agoessling/godwit/README.md

godwit
======

Low-Cost Gliding Computer
