agoessling/godwit/hardware/v01/electrical/fab/panelized/README.txt

Board Thickness: 1.6mm
Surface Finish Green Soldermask with White Silkscreen
Copper Weight: 1 Oz. Top and Bottom
