agoessling/godwit/hardware/v01/mechanical/eagleup/eagleUp_godwit-v01_board_bottom.png

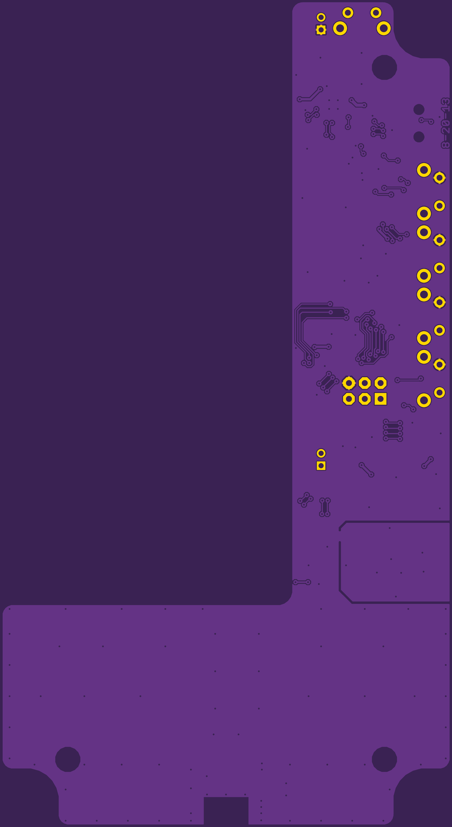
hardware/v01/mechanical/eagleup/eagleUp_godwit-v01_board_bottom.png
