agoessling/godwit/hardware/v01/mechanical/eagleup/eagleUp_godwit-v01_bottom_mask.png

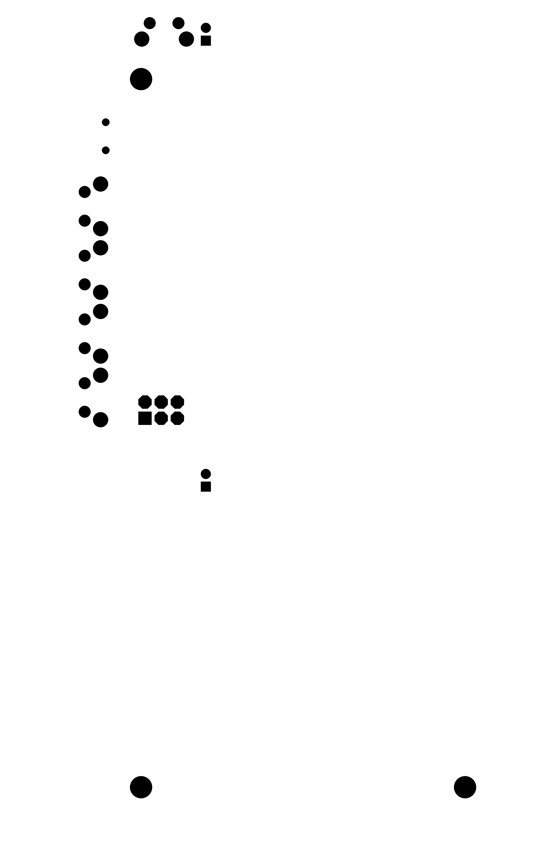
hardware/v01/mechanical/eagleup/eagleUp_godwit-v01_bottom_mask.png
