agoessling/godwit/hardware/v01/mechanical/eagleup/eagleUp_godwit-v01_imagesize.png

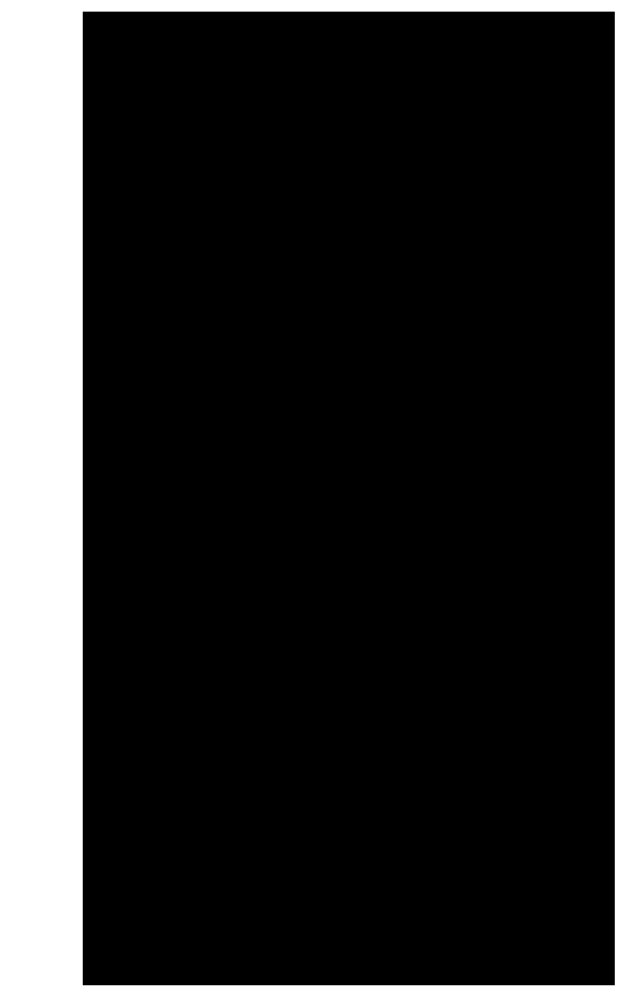
hardware/v01/mechanical/eagleup/eagleUp_godwit-v01_imagesize.png
