agoessling/godwit/hardware/v01/mechanical/eagleup/eagleUp_godwit-v01_outline.png

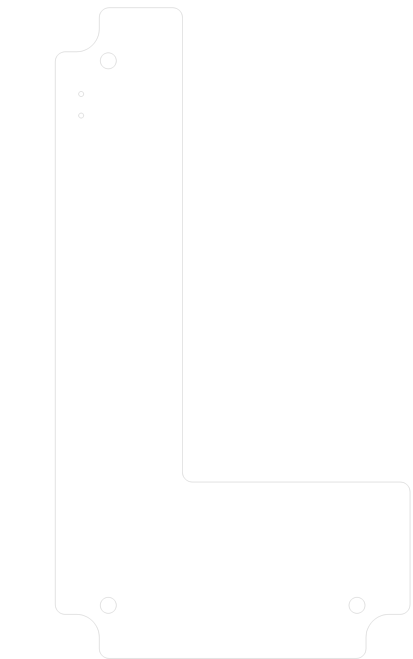
hardware/v01/mechanical/eagleup/eagleUp_godwit-v01_outline.png
