agoessling/godwit/hardware/v01/mechanical/eagleup/eagleUp_godwit-v01_top_mask.png

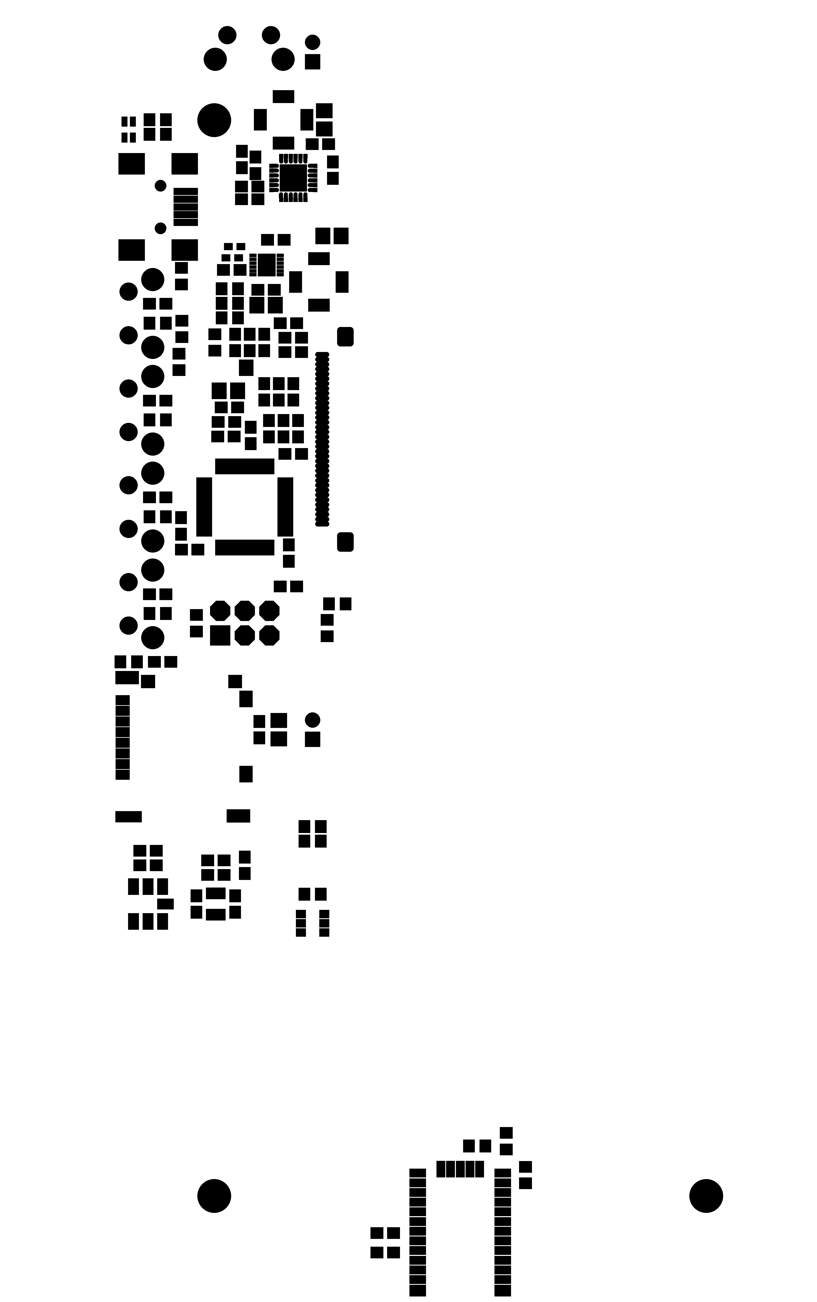
hardware/v01/mechanical/eagleup/eagleUp_godwit-v01_top_mask.png
