agoessling/godwit/hardware/v01/mechanical/eagleup/eagleUp_godwit-v01_top_silk.png

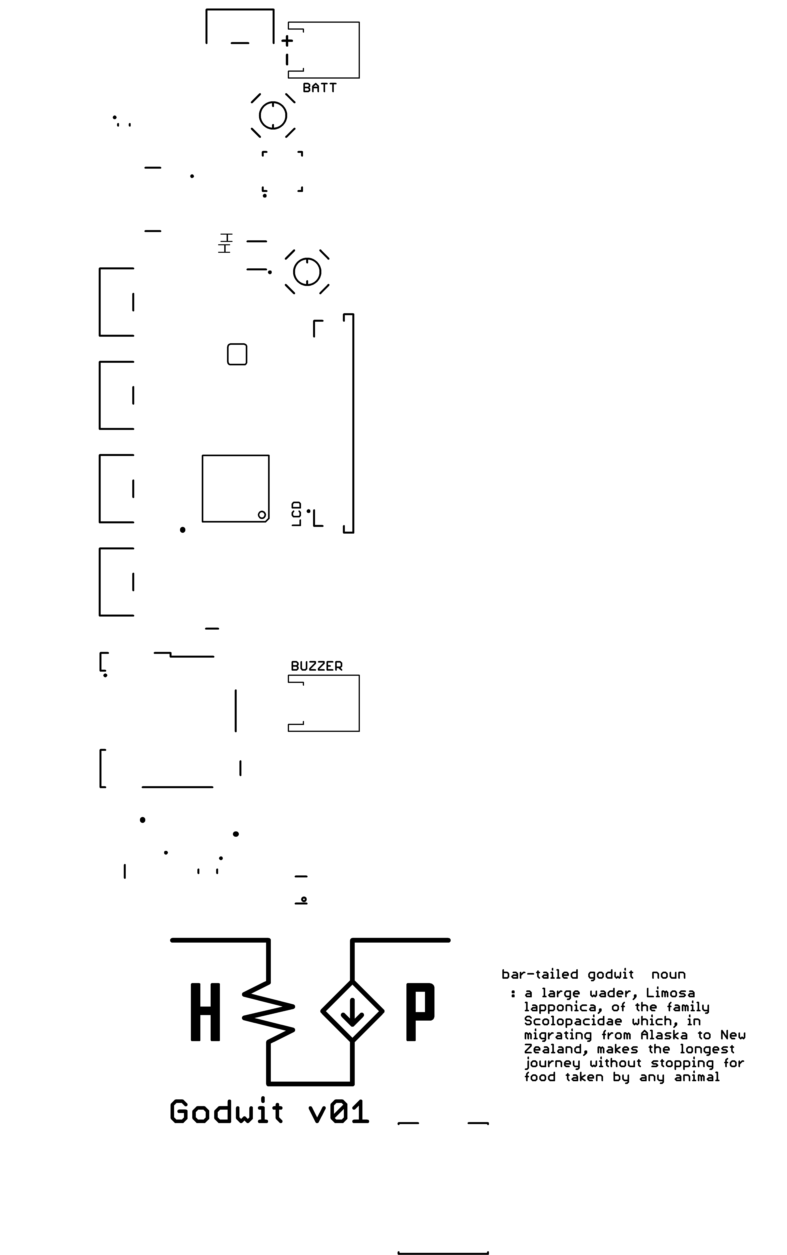
hardware/v01/mechanical/eagleup/eagleUp_godwit-v01_top_silk.png
