agoessling/godwit/hardware/v01/mechanical/godwit_outline.dxf

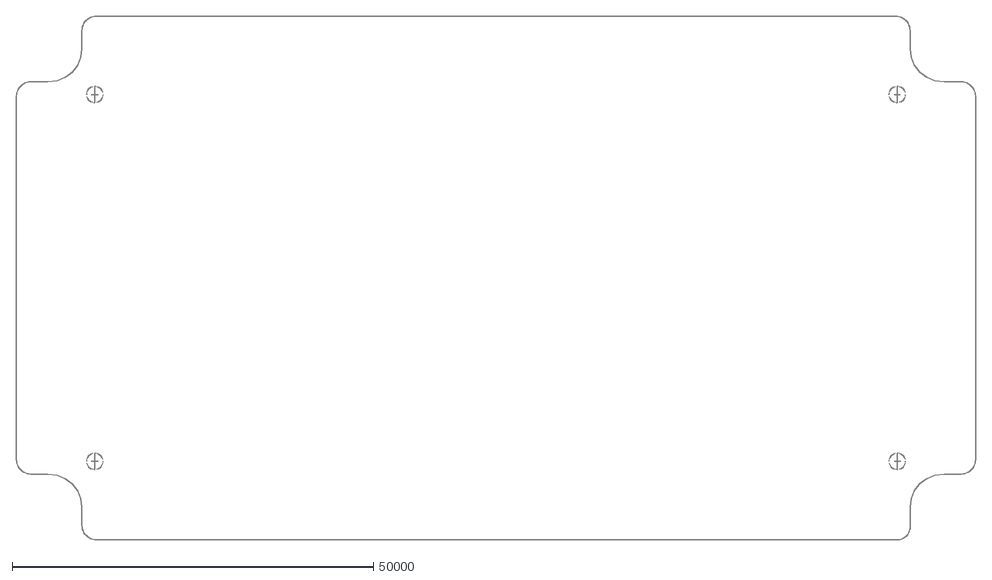
[picture p15: CAD file, 2013-08-06]
hardware/v01/mechanical/godwit_outline.dxf
132828.1 x 72520.8
