agoessling/godwit/(list of files, cad)

Other CAD files:
hardware/v01/mechanical/godwit.skp
