agoessling/godwit/hardware/v01/electrical/godwit-v01.pdf

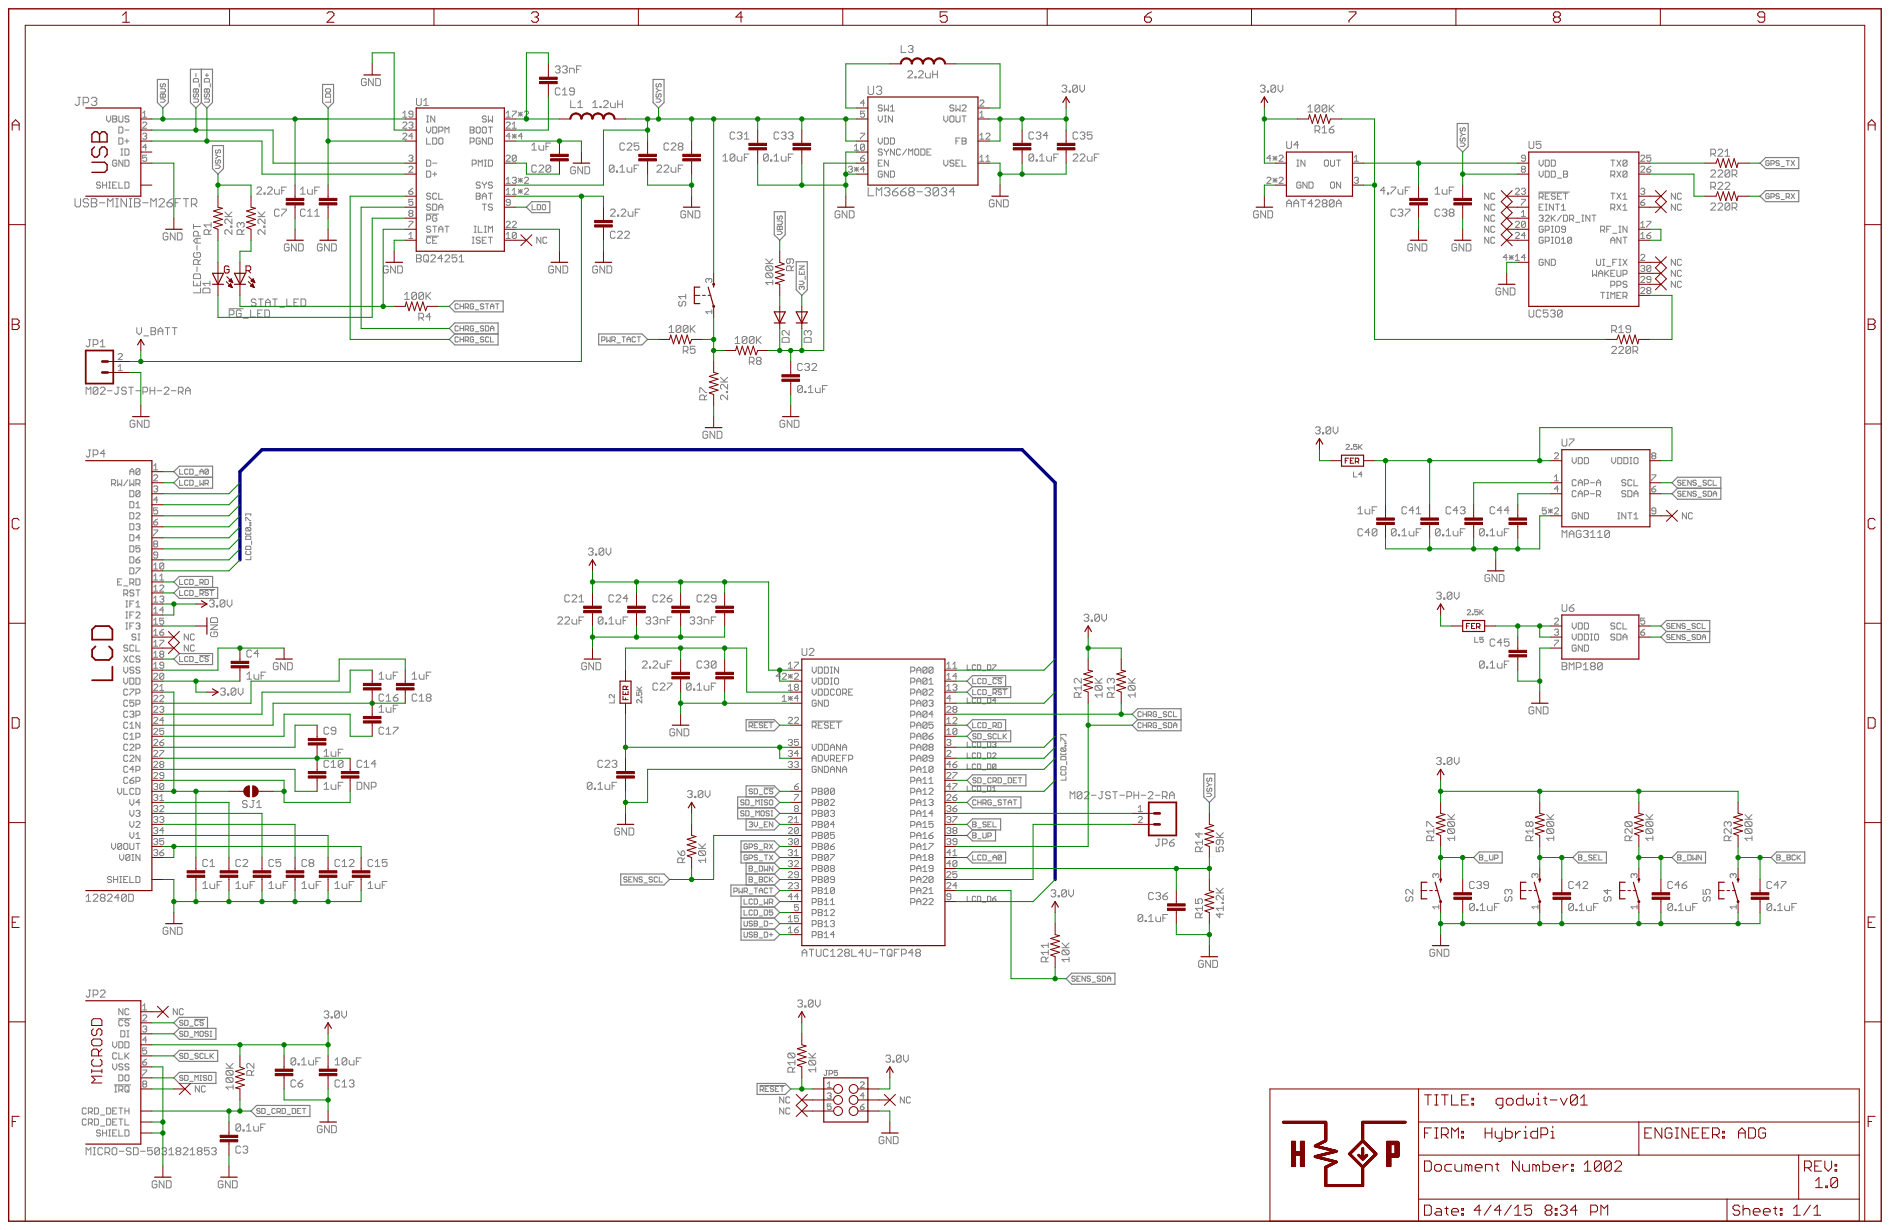
[picture p16: page 1]
