agoessling/godwit/hardware/v01/electrical/godwit-v01.brd

## EAGLE design hardware/v01/electrical/godwit-v01.brd (2013-08-22)

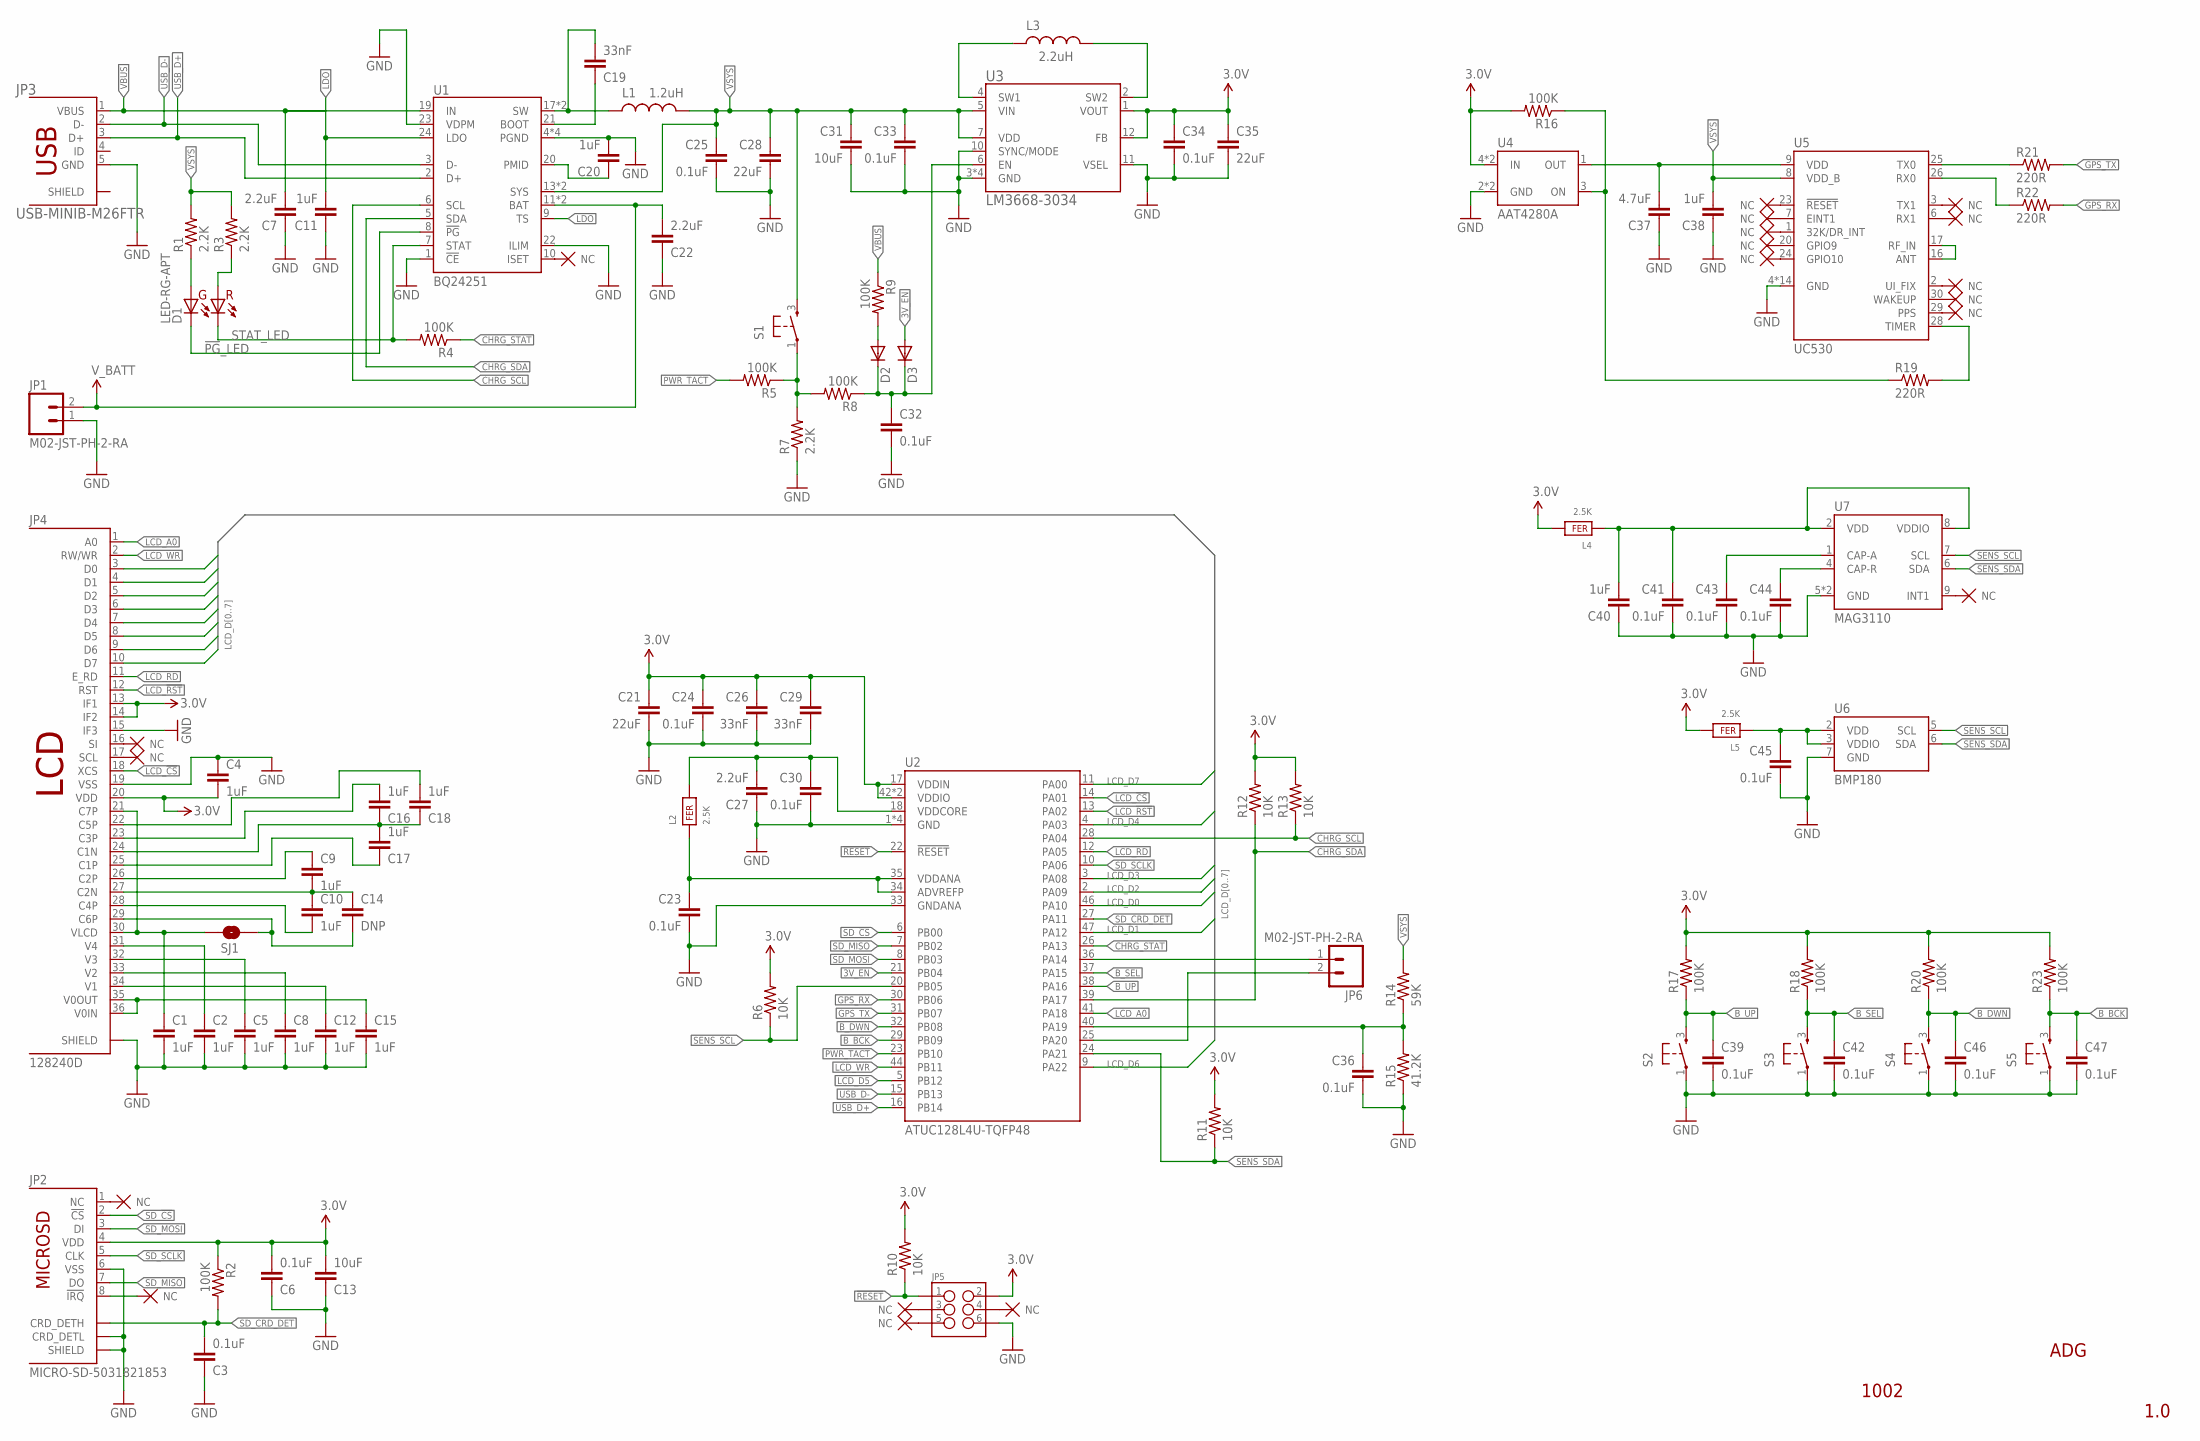
[picture p17: schematic godwit-v01.sch]

Parts:
C1, C2, C4, C5, C8, C9, C10, C12, C15, C16, C17, C18: 1uF; C0603
C3, C6, C23, C24, C25, C30, C32, C33, C34, C36, C39, C41, C42, C43, C44, C45, C46, C47: 0.1uF; C0603
C7, C22, C27: 2.2uF; C0603
C11, C20, C38, C40: 1uF; C0603; VOLTAGE >=10V
C13, C31: 10uF; C0805
C14: DNP; C0603
C19: 33nF; C0603; VOLTAGE >15
C21, C28, C35: 22uF; C0805
C26, C29: 33nF; C0603
C37: 4.7uF; C0603; VOLTAGE >=10V
D1: LED-RG-APT; LED-2-1.6X1.25
D2, D3: 1N4148X-TP; SOD523
JP1, JP6: M02-JST-PH-2-RA; JST-PH-2-RA
JP2: MICRO-SD-5031821853; MICROSD-5031821853
JP3: USB-MINIB-M26FTR
JP4: 128240D
JP5: M03X2NO_SILK; 2X3-NS
L1: 1.2uH; SRU5028
L2, L4, L5: 2.5K; 0603
L3: 2.2uH; SRU5028
R1, R3, R7: 2.2K; R0603
R2, R4, R5, R8, R9, R16, R17, R18, R20, R23: 100K; R0603
R6, R10, R11, R12, R13: 10K; R0603
R14: 59K; R0603
R15: 41.2K; R0603
R19, R21, R22: 220R; R0603
S1, S2, S3, S4, S5: FSMRA7JH; FSMRA
SJ1: SOLDERJUMPERNC; SJ_2S
U1: BQ24251; VQFN-24
U2: ATUC128L4U-TQFP48; TQFP48
U3: LM3668-3034; WSON-12
U4: AAT4280A; SOT23-6
U5: UC530
U6: BMP180
U7: MAG3110; DFN-10-2X2

Connections:
3.0V: C4.2, C6.2, C13.2, C21.1, C24.1, C26.1, C29.1, C34.1, C35.1, JP2.4 (VDD), JP4.13 (IF1), JP4.14 (IF2), JP4.20 (VDD), JP5.2, L4.2, L5.2, R2.1, R6.2, R10.2, R11.2, R12.2, R13.2, R16.2, R17.2, R18.2, R20.2, R23.2, U2.17 (VDDIN), U2.42 (VDDIO), U2.48 (VDDIO), U3.1 (VOUT), U3.12 (FB), U4.4 (IN), U4.6 (IN)
3V_EN: D3.A, U2.21 (PB04)
!PG!_LED: D1.4 (CG), U1.8 (!PG!)
!RESET!: JP5.1, R10.1, U2.22 (!RESET!)
B_BCK: C47.1, R23.1, S5.3 (2), U2.29 (PB09)
B_DWN: C46.1, R20.1, S4.3 (2), U2.32 (PB08)
B_SEL: C42.1, R18.1, S3.3 (2), U2.37 (PA15)
B_UP: C39.1, R17.1, S2.3 (2), U2.38 (PA16)
CHRG_SCL: R13.1, U1.6 (SCL), U2.28 (PA04)
CHRG_SDA: R12.1, U1.5 (SDA), U2.39 (PA17)
CHRG_STAT: R4.1, U2.26 (PA13)
GND: C1.2, C2.2, C3.1, C4.1, C5.2, C6.1, C7.1, C8.2, C11.1, C12.2, C13.1, C15.2, C20.2, C21.2, C22.1, C23.2, C24.2, C25.2, C26.2, C27.1, C28.2, C29.2, C30.2, C31.2, C32.2, C33.2, C34.2, C35.2, C36.2, C37.1, C38.1, C39.2, C40.1, C41.2, C42.2, C43.2, C44.2, C45.2, C46.2, C47.2, JP1.1, JP2.6 (VSS), JP2.CRD_DETL, JP2.SHIELD1 (SHIELD), JP2.SHIELD2 (SHIELD), JP2.SHIELD3 (SHIELD), JP2.SHIELD4 (SHIELD), JP2.SHIELD5 (SHIELD), JP3.5 (GND), JP4.15 (IF3), JP4.19 (VSS), JP4.SHIELD1 (SHIELD), JP4.SHIELD2 (SHIELD), JP5.6, R7.1, R15.1, S2.1, S3.1, S4.1, S5.1, U1.1 (!CE!), U1.4 (PGND), U1.15 (PGND), U1.16 (PGND), U1.22 (ILIM), U1.23 (VDPM), U1.PAD (PGND), U2.1 (GND), U2.19 (GND), U2.33 (GNDANA), U2.43 (GND), U2.45 (GND), U3.3 (GND), U3.8 (GND), U3.9 (GND), U3.10 (SYNC/MODE), U3.11 (VSEL), U3.PAD (GND), U4.2 (GND), U4.5 (GND), U5.4 (GND), U5.5 (GND), U5.10 (GND), U5.11 (GND), U5.12 (GND), U5.13 (GND), U5.14 (GND), U5.15 (GND), U5.18 (GND), U5.19 (GND), U5.21 (GND), U5.22 (GND), U5.27 (GND), U5.31 (GND), U6.7 (GND), U7.5 (GND), U7.10 (GND)
GPS_RX: R22.2, U2.30 (PB06)
GPS_TX: R21.2, U2.31 (PB07)
LCD_!CS!: JP4.18 (XCS), U2.14 (PA01)
LCD_!RST!: JP4.12 (RST), U2.13 (PA02)
LCD_A0: JP4.1 (A0), U2.41 (PA18)
LCD_D0: JP4.3 (D0), U2.46 (PA10)
LCD_D1: JP4.4 (D1), U2.47 (PA12)
LCD_D2: JP4.5 (D2), U2.2 (PA09)
LCD_D3: JP4.6 (D3), U2.3 (PA08)
LCD_D4: JP4.7 (D4), U2.4 (PA03)
LCD_D5: JP4.8 (D5), U2.5 (PB12)
LCD_D6: JP4.9 (D6), U2.9 (PA22)
LCD_D7: JP4.10 (D7), U2.11 (PA00)
LCD_RD: JP4.11 (E_RD), U2.12 (PA05)
LCD_WR: JP4.2 (RW/WR), U2.44 (PB11)
LDO: C11.2, U1.9 (TS), U1.24 (LDO)
unnamed: L3.2, U3.2 (SW2)
unnamed: L3.1, U3.4 (SW1)
unnamed: C19.1, U1.21 (BOOT)
unnamed: U5.16 (ANT), U5.17 (RF_IN)
unnamed: C19.2, L1.1, U1.17 (SW), U1.18 (SW)
unnamed: C20.1, U1.20 (PMID)
unnamed: D2.A, R9.2
unnamed: C32.1, D2.C, D3.C, R8.1, U3.6 (EN)
unnamed: D1.3 (AG), R1.1
unnamed: D1.1 (AR), R3.1
unnamed: C37.2, U4.1 (OUT), U5.9 (VDD)
unnamed: R21.1, U5.25 (TX0)
unnamed: R22.1, U5.26 (RX0)
unnamed: R19.2, U5.28 (TIMER)
unnamed: R16.1, R19.1, U4.3 (ON)
unnamed: C9.2, C10.1, C14.1, JP4.27 (C2N)
unnamed: C44.1, U7.4 (CAP-R)
unnamed: C43.1, U7.1 (CAP-A)
unnamed: C9.1, JP4.26 (C2P)
unnamed: C10.2, JP4.28 (C4P)
unnamed: C14.2, JP4.29 (C6P), SJ1.2
unnamed: C16.1, C17.2, C18.1, JP4.24 (C1N)
unnamed: C17.1, JP4.25 (C1P)
unnamed: C16.2, JP4.23 (C3P)
unnamed: C18.2, JP4.22 (C5P)
unnamed: C2.1, JP4.31 (V4)
unnamed: C5.1, JP4.32 (V3)
unnamed: C1.1, JP4.21 (C7P), JP4.30 (VLCD), SJ1.1
unnamed: C8.1, JP4.33 (V2)
unnamed: C12.1, JP4.34 (V1)
unnamed: C15.1, JP4.35 (V0OUT), JP4.36 (V0IN)
unnamed: C36.1, R14.1, R15.2, U2.40 (PA19)
unnamed: JP6.1, U2.36 (PA14)
unnamed: C45.1, L5.1, U6.2 (VDD), U6.3 (VDDIO)
unnamed: JP6.2, U2.25 (PA20)
unnamed: C23.1, L2.1, U2.34 (ADVREFP), U2.35 (VDDANA)
unnamed: C27.2, C30.1, L2.2, U2.18 (VDDCORE)
unnamed: C40.2, C41.1, L4.1, U7.2 (VDD), U7.8 (VDDIO)
unnamed: R5.1, R7.2, R8.2, S1.1
PWR_TACT: R5.2, U2.23 (PB10)
SD_!CS!: JP2.2 (!CS!), U2.6 (PB00)
SD_CRD_DET: C3.2, JP2.CRD_DETH, R2.2, U2.27 (PA11)
SD_MISO: JP2.7 (DO), U2.7 (PB02)
SD_MOSI: JP2.3 (DI), U2.8 (PB03)
SD_SCLK: JP2.5 (CLK), U2.10 (PA06)
SENS_SCL: R6.1, U2.20 (PB05), U6.5 (SCL), U7.7 (SCL)
SENS_SDA: R11.1, U2.24 (PA21), U6.6 (SDA), U7.6 (SDA)
STAT_LED: D1.2 (CR), R4.2, U1.7 (STAT)
USB_D+: JP3.3 (D+), U1.2 (D+), U2.16 (PB14)
USB_D-: JP3.2 (D-), U1.3 (D-), U2.15 (PB13)
VBUS: C7.2, JP3.1 (VBUS), R9.1, U1.19 (IN)
VSYS: C25.1, C28.1, C31.1, C33.1, C38.2, L1.2, R1.2, R3.2, R14.2, S1.3 (2), U1.13 (SYS), U1.14 (SYS), U3.5 (VIN), U3.7 (VDD), U5.8 (VDD_B)
V_BATT: C22.2, JP1.2, U1.11 (BAT), U1.12 (BAT)

Notes on the sheet:
ADG
1002
1.0

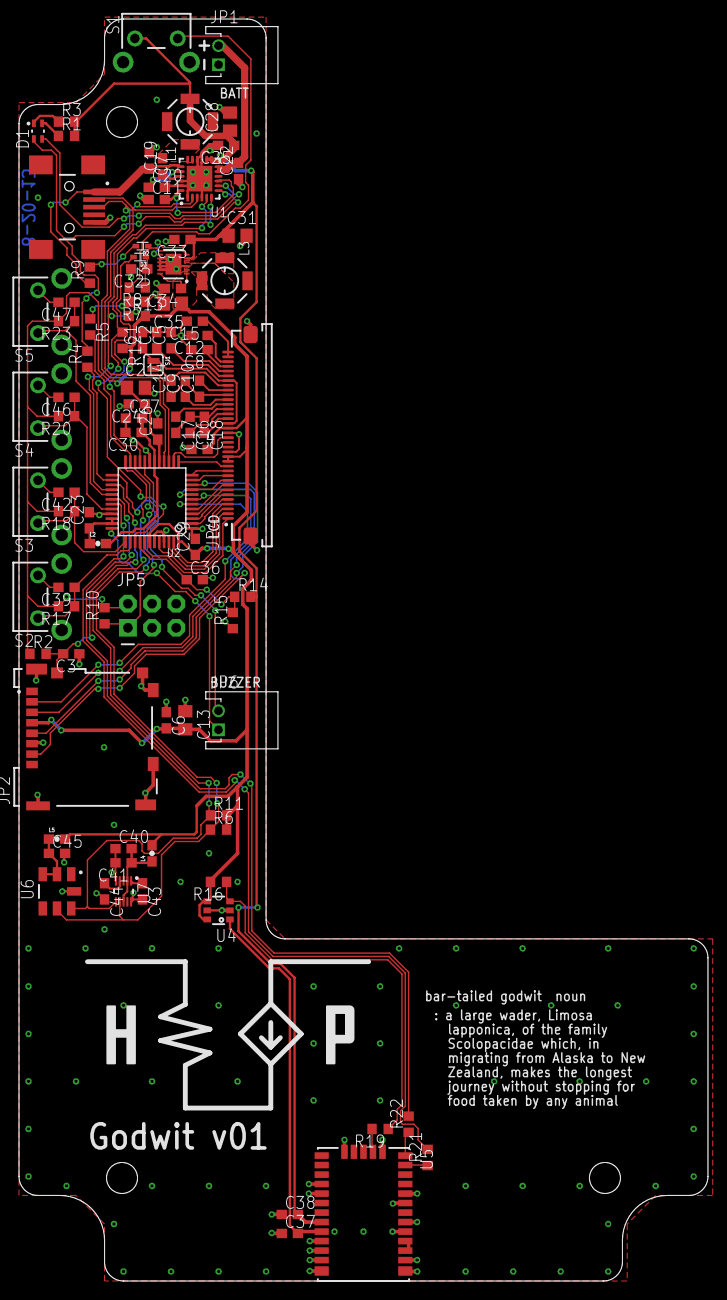
[picture p18: board godwit-v01.brd from above]

Board: 2 copper layers, 72.5 x 132.8 mm, 98 parts (0 on the bottom side), 81 nets.

Other parts of the board:
U$21: LOGO_MED_SLK
