agoessling/godwit/hardware/v01/electrical/godwit-v01-panel.brd

## EAGLE design hardware/v01/electrical/godwit-v01-panel.brd (2013-08-21)

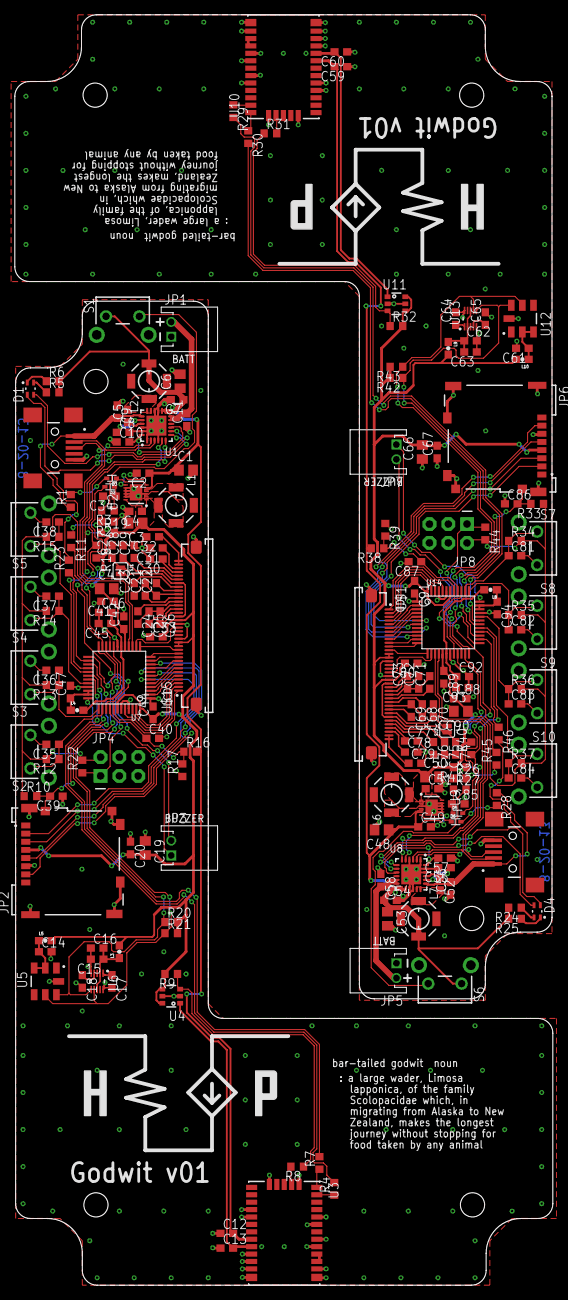
[picture p19: board godwit-v01-panel.brd from above]

Board: 2 copper layers, 72.6 x 171.4 mm, 196 parts (0 on the bottom side), 162 nets.

Parts:
C1, C19, C48, C66: 10uF; C0805
C2, C4, C7, C14, C15, C17, C18, C20, C34, C35, C36, C37, C38, C39, C40, C41, C45, C47, C49, C51, C54, C61, C62, C64, C65, C67, C81, C82, C83, C84, C85, C86, C87, C88, C92, C94: 0.1uF; C0603
C3, C6, C43, C50, C53, C90: 22uF; C0805
C5, C42, C44, C52, C89, C91: 33nF; C0603
C8, C10, C12, C16, C21, C22, C24, C25, C26, C27, C28, C29, C30, C31, C32, C33, C55, C57, C59, C63, C68, C69, C71, C72, C73, C74, C75, C76, C77, C78, C79, C80: 1uF; C0603
C9, C11, C46, C56, C58, C93: 2.2uF; C0603
C13, C60: 4.7uF; C0603
C23, C70: DNP; C0603
D1, D4: LED-RG-APT; LED-2-1.6X1.25
D2, D3, D5, D6: SOD523
J1, J2: USB-MINIB-M26FTR
JP1, JP3, JP5, JP7: M02-JST-PH-2-RA; JST-PH-2-RA
JP2, JP6: MICRO-SD-5031821853; MICROSD-5031821853
JP4, JP8: 2X3-NS
L1, L6: 2.2uH; SRU5028
L2, L7: 1uH; SRU5028
L3, L4, L5, L8, L9, L10: 2.5K; 0603
R1, R3, R9, R10, R11, R12, R13, R14, R15, R23, R27, R28, R32, R33, R34, R35, R36, R37, R45, R46: 100K; R0603
R2, R5, R6, R24, R25, R26: 2.2K; R0603
R4, R7, R8, R29, R30, R31: 220R; R0603
R16, R38: 59K; R0603
R17, R39: 41.2K; R0603
R18, R19, R20, R21, R22, R40, R41, R42, R43, R44: 10K; R0603
S1, S2, S3, S4, S5, S6, S7, S8, S9, S10: FSMRA
SJ1, SJ2: SOLDERJUMPERNC; SJ_2S
U1, U8: BQ24251; VQFN-24
U2, U9: LM3668-3034; WSON-12
U3, U10: UC530
U4, U11: AAT4280A; SOT23-6
U5, U12: BMP180
U6, U13: MAG3110; DFN-10-2X2
U7, U14: ATUCL4U-TQFP48; TQFP48
U$1, U$15: 128240D
U$2, U$21: LOGO_MED_SLK

Connections:
3.0V: C3.1, C4.1, C19.2, C20.2, C33.2, C41.1, C42.1, C43.1, C44.1, JP2.4, JP4.2, L3.2, L5.2, R9.2, R10.1, R12.2, R13.2, R14.2, R15.2, R18.2, R19.2, R20.2, R21.2, R22.2, U2.1, U2.12, U4.4, U4.6, U7.17, U7.42, U7.48, U$15.13, U$15.14, U$15.20
3.0V1: C50.1, C51.1, C66.2, C67.2, C80.2, C88.1, C89.1, C90.1, C91.1, JP6.4, JP8.2, L9.2, L10.2, R32.2, R33.1, R34.2, R35.2, R36.2, R37.2, R40.2, R41.2, R42.2, R43.2, R44.2, U9.1, U9.12, U11.4, U11.6, U14.17, U14.42, U14.48, U$1.13, U$1.14, U$1.20
3V_EN: D2.A, U7.21
3V_EN1: D5.A, U14.21
!PG!_LED: D1.4, U1.8
!PG!_LED1: D4.4, U8.8
!RESET!: JP4.1, R22.1, U7.22
!RESET!1: JP8.1, R44.1, U14.22
B_BCK: C38.1, R15.1, S5.3, U7.29
B_BCK1: C84.1, R37.1, S10.3, U14.29
B_DWN: C37.1, R14.1, S4.3, U7.32
B_DWN1: C83.1, R36.1, S9.3, U14.32
B_SEL: C36.1, R13.1, S3.3, U7.37
B_SEL1: C82.1, R35.1, S8.3, U14.37
B_UP: C35.1, R12.1, S2.3, U7.38
B_UP1: C81.1, R34.1, S7.3, U14.38
CHRG_SCL: R19.1, U1.6, U7.28
CHRG_SCL1: R41.1, U8.6, U14.28
CHRG_SDA: R18.1, U1.5, U7.39
CHRG_SDA1: R40.1, U8.5, U14.39
CHRG_STAT: R23.1, U7.26
CHRG_STAT1: R46.1, U14.26
GND: C1.2, C2.2, C3.2, C4.2, C6.2, C7.2, C8.2, C9.1, C10.1, C11.1, C12.1, C13.1, C14.2, C15.2, C16.1, C17.2, C18.2, C19.1, C20.1, C27.2, C28.2, C29.2, C30.2, C31.2, C32.2, C33.1, C34.2, C35.2, C36.2, C37.2, C38.2, C39.1, C40.2, C41.2, C42.2, C43.2, C44.2, C45.2, C46.1, C47.2, J1.5, JP1.1, JP2.6, JP2.CRD_DETL, JP2.SHIELD1, JP2.SHIELD2, JP2.SHIELD3, JP2.SHIELD4, JP2.SHIELD5, JP4.6, R2.1, R17.1, S2.1, S3.1, S4.1, S5.1, U1.1, U1.4, U1.15, U1.16, U1.22, U1.23, U1.PAD, U2.3, U2.8, U2.9, U2.10, U2.11, U2.PAD, U3.4, U3.5, U3.10, U3.11, U3.12, U3.13, U3.14, U3.15, U3.18, U3.19, U3.21, U3.22, U3.27, U3.31, U4.2, U4.5, U5.7, U6.5, U6.10, U7.1, U7.19, U7.33, U7.43, U7.45, U$15.15, U$15.19, U$15.SHIELD1, U$15.SHIELD2
GND1: C48.2, C49.2, C50.2, C51.2, C53.2, C54.2, C55.2, C56.1, C57.1, C58.1, C59.1, C60.1, C61.2, C62.2, C63.1, C64.2, C65.2, C66.1, C67.1, C74.2, C75.2, C76.2, C77.2, C78.2, C79.2, C80.1, C81.2, C82.2, C83.2, C84.2, C85.2, C86.1, C87.2, C88.2, C89.2, C90.2, C91.2, C92.2, C93.1, C94.2, J2.5, JP5.1, JP6.6, JP6.CRD_DETL, JP6.SHIELD1, JP6.SHIELD2, JP6.SHIELD3, JP6.SHIELD4, JP6.SHIELD5, JP8.6, R26.1, R39.1, S7.1, S8.1, S9.1, S10.1, U8.1, U8.4, U8.15, U8.16, U8.22, U8.23, U8.PAD, U9.3, U9.8, U9.9, U9.10, U9.11, U9.PAD, U10.4, U10.5, U10.10, U10.11, U10.12, U10.13, U10.14, U10.15, U10.18, U10.19, U10.21, U10.22, U10.27, U10.31, U11.2, U11.5, U12.7, U13.5, U13.10, U14.1, U14.19, U14.33, U14.43, U14.45, U$1.15, U$1.19, U$1.SHIELD1, U$1.SHIELD2
GPS_RX: R7.2, U7.30
GPS_RX1: R30.2, U14.30
GPS_TX: R4.2, U7.31
GPS_TX1: R29.2, U14.31
LCD_!CS!: U7.14, U$15.18
LCD_!CS!1: U14.14, U$1.18
LCD_!RST!: U7.13, U$15.12
LCD_!RST!1: U14.13, U$1.12
LCD_A0: U7.41, U$15.1
LCD_A1: U14.41, U$1.1
LCD_D0: U7.46, U$15.3
LCD_D1: U7.47, U$15.4
LCD_D2: U7.2, U$15.5
LCD_D3: U7.3, U$15.6
LCD_D4: U7.4, U$15.7
LCD_D5: U7.5, U$15.8
LCD_D6: U7.9, U$15.9
LCD_D7: U7.11, U$15.10
LCD_D8: U14.11, U$1.10
LCD_D9: U14.9, U$1.9
LCD_D10: U14.5, U$1.8
LCD_D11: U14.4, U$1.7
LCD_D12: U14.3, U$1.6
LCD_D13: U14.47, U$1.4
LCD_D14: U14.46, U$1.3
LCD_D15: U14.2, U$1.5
LCD_RD: U7.12, U$15.11
LCD_RD1: U14.12, U$1.11
LCD_WR: U7.44, U$15.2
LCD_WR1: U14.44, U$1.2
LDO: C10.2, U1.9, U1.24
LDO1: C57.2, U8.9, U8.24
unnamed: L1.2, U2.2
unnamed: L1.1, U2.4
unnamed: C5.1, U1.21
unnamed: U3.16, U3.17
unnamed: C5.2, L2.1, U1.17, U1.18
unnamed: C8.1, U1.20
unnamed: D3.A, R1.2
unnamed: C34.1, D2.C, D3.C, R3.1, U2.6
unnamed: D1.3, R5.1
unnamed: D1.1, R6.1
unnamed: C13.2, U3.9, U4.1
unnamed: R4.1, U3.25
unnamed: R7.1, U3.26
unnamed: R8.2, U3.28
unnamed: R8.1, R9.1, U4.3
unnamed: C21.2, C22.1, C23.1, U$15.27
unnamed: C18.1, U6.4
unnamed: C17.1, U6.1
unnamed: C21.1, U$15.26
unnamed: C22.2, U$15.28
unnamed: C23.2, SJ1.2, U$15.29
unnamed: C24.2, C25.1, C26.1, U$15.24
unnamed: C24.1, U$15.25
unnamed: C25.2, U$15.23
unnamed: C26.2, U$15.22
unnamed: C28.1, U$15.31
unnamed: C29.1, U$15.32
unnamed: C27.1, SJ1.1, U$15.21, U$15.30
unnamed: C30.1, U$15.33
unnamed: C31.1, U$15.34
unnamed: C32.1, U$15.35, U$15.36
unnamed: C40.1, R16.1, R17.2, U7.40
unnamed: JP3.1, U7.36
unnamed: C14.1, L5.1, U5.2, U5.3
unnamed: JP3.2, U7.25
unnamed: C47.1, L4.1, U7.34, U7.35
unnamed: C45.1, C46.2, L4.2, U7.18
unnamed: C15.1, C16.2, L3.1, U6.2, U6.8
unnamed: L6.2, U9.2
unnamed: L6.1, U9.4
unnamed: C52.1, U8.21
unnamed: C52.2, L7.1, U8.17, U8.18
unnamed: C55.1, U8.20
unnamed: D4.3, R24.1
unnamed: D4.1, R25.1
unnamed: D6.A, R28.2
unnamed: C85.1, D5.C, D6.C, R27.1, U9.6
unnamed: U10.16, U10.17
unnamed: C60.2, U10.9, U11.1
unnamed: R29.1, U10.25
unnamed: R30.1, U10.26
unnamed: R31.2, U10.28
unnamed: R31.1, R32.1, U11.3
unnamed: C65.1, U13.4
unnamed: C64.1, U13.1
unnamed: R2.2, R3.2, R11.1, S1.1
unnamed: C68.2, C69.1, C70.1, U$1.27
unnamed: C68.1, U$1.26
unnamed: C69.2, U$1.28
unnamed: C70.2, SJ2.2, U$1.29
unnamed: C71.2, C72.1, C73.1, U$1.24
unnamed: C71.1, U$1.25
unnamed: C72.2, U$1.23
unnamed: C73.2, U$1.22
unnamed: C74.1, SJ2.1, U$1.21, U$1.30
unnamed: C75.1, U$1.31
unnamed: C76.1, U$1.32
unnamed: C77.1, U$1.33
unnamed: C78.1, U$1.34
unnamed: C79.1, U$1.35, U$1.36
unnamed: C87.1, R38.1, R39.2, U14.40
unnamed: JP7.1, U14.36
unnamed: JP7.2, U14.25
unnamed: C92.1, C93.2, L8.2, U14.18
unnamed: C94.1, L8.1, U14.34, U14.35
unnamed: C61.1, L10.1, U12.2, U12.3
unnamed: C62.1, C63.2, L9.1, U13.2, U13.8
unnamed: R26.2, R27.2, R45.1, S6.1
PWR_TACT: R11.2, U7.23
PWR_TACT1: R45.2, U14.23
SD_!CS!: JP2.2, U7.6
SD_!CS!1: JP6.2, U14.6
SD_CRD_DET: C39.2, JP2.CRD_DETH, R10.2, U7.27
SD_CRD_DET1: C86.2, JP6.CRD_DETH, R33.2, U14.27
SD_MISO: JP2.7, U7.7
SD_MISO1: JP6.7, U14.7
SD_MOSI: JP2.3, U7.8
SD_MOSI1: JP6.3, U14.8
SD_SCLK: JP2.5, U7.10
SD_SCLK1: JP6.5, U14.10
SENS_SCL: R21.1, U5.5, U6.7, U7.20
SENS_SCL1: R43.1, U12.5, U13.7, U14.20
SENS_SDA: R20.1, U5.6, U6.6, U7.24
SENS_SDA1: R42.1, U12.6, U13.6, U14.24
STAT_LED: D1.2, R23.2, U1.7
STAT_LED1: D4.2, R46.2, U8.7
USB_D+: J1.3, U1.2, U7.16
USB_D+1: J2.3, U8.2, U14.16
USB_D-: J1.2, U1.3, U7.15
USB_D-1: J2.2, U8.3, U14.15
VBUS: C9.2, J1.1, R1.1, U1.19
VBUS1: C56.2, J2.1, R28.1, U8.19
VSYS: C1.1, C2.1, C6.1, C7.1, C12.2, L2.2, R5.2, R6.2, R16.2, S1.3, U1.13, U1.14, U2.5, U2.7, U3.8
VSYS1: C48.1, C49.1, C53.1, C54.1, C59.2, L7.2, R24.2, R25.2, R38.2, S6.3, U8.13, U8.14, U9.5, U9.7, U10.8
V_BATT: C11.2, JP1.2, U1.11, U1.12
V_BATT1: C58.2, JP5.2, U8.11, U8.12
