agoessling/godwit/(commit log)

2013-08-06 Moved directory structure.
    [godwit-v01.sch, godwit.skp, godwit_outline.dxf]
2013-08-06 rearranged and added circuits
    [godwit-v01.sch]
2013-08-07 Added sensing circuitry.
    [godwit-v01.sch]
2013-08-08 Added SD card circuit.
    [godwit-v01.sch]
2013-08-08 Added LCD and uC to circuit
    [godwit-v01.sch]
2013-08-10 Added LCD signals and EXTINT.
    [godwit-v01.sch]
2013-08-17 Started ADC input.
    [godwit-v01.sch]
2013-08-19 Finished first draft schematic and layout.
    [godwit-v01.brd, godwit-v01.sch]
2013-08-20 Spun sd card right way and rerouted...
    [godwit-v01.brd, godwit-v01.sch]
2013-08-20 Finished EagleUp
    [godwit-v01.brd, godwit-v01.sch]
2013-08-21 Added current limiting resistors and finalized v01 design.
    [godwit-v01-panel.brd, godwit-v01.brd, godwit-v01.sch]
2013-08-21 panelized and gerbered.
    [godwit-v01-panel.brd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]
2013-08-22 Prepared Fab documents, and sent off v01.
    [godwit-v01-panel.drills.xln, godwit-v01.GBL, godwit-v01.GBO, godwit-v01.GBS, godwit-v01.GTL, godwit-v01.GTO, godwit-v01.GTP, godwit-v01.GTS]
2013-08-22 Started to add BOM.
    [bom.ods, godwit-v01-bom.csv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]
2013-08-22 Finished BOM
    [bom.ods, godwit-v01-bom.csv, godwit-v01.brd, godwit-v01.sch]
2013-08-23 added to BOM
    [godwit-v01-bom.csv]
2013-08-23 Purchased from BOM.
    [godwit-v01-bom.csv, godwit-v01-bom.xls]
2013-08-28 Changed sketchup assembly
2013-09-03 Added board specific file for st7529.
2013-10-07 Wrote Mag and Pressure Support.
    Setup serial dma support for pressure and then mag.
2013-10-08 Added GPS-Synced Tick Interrupt
2013-10-15 Setup Buzzer PWM
